fourstix/PicoElfPixieVideoGLCD/docs/PicoElfPixieVideoGLCD.pdf

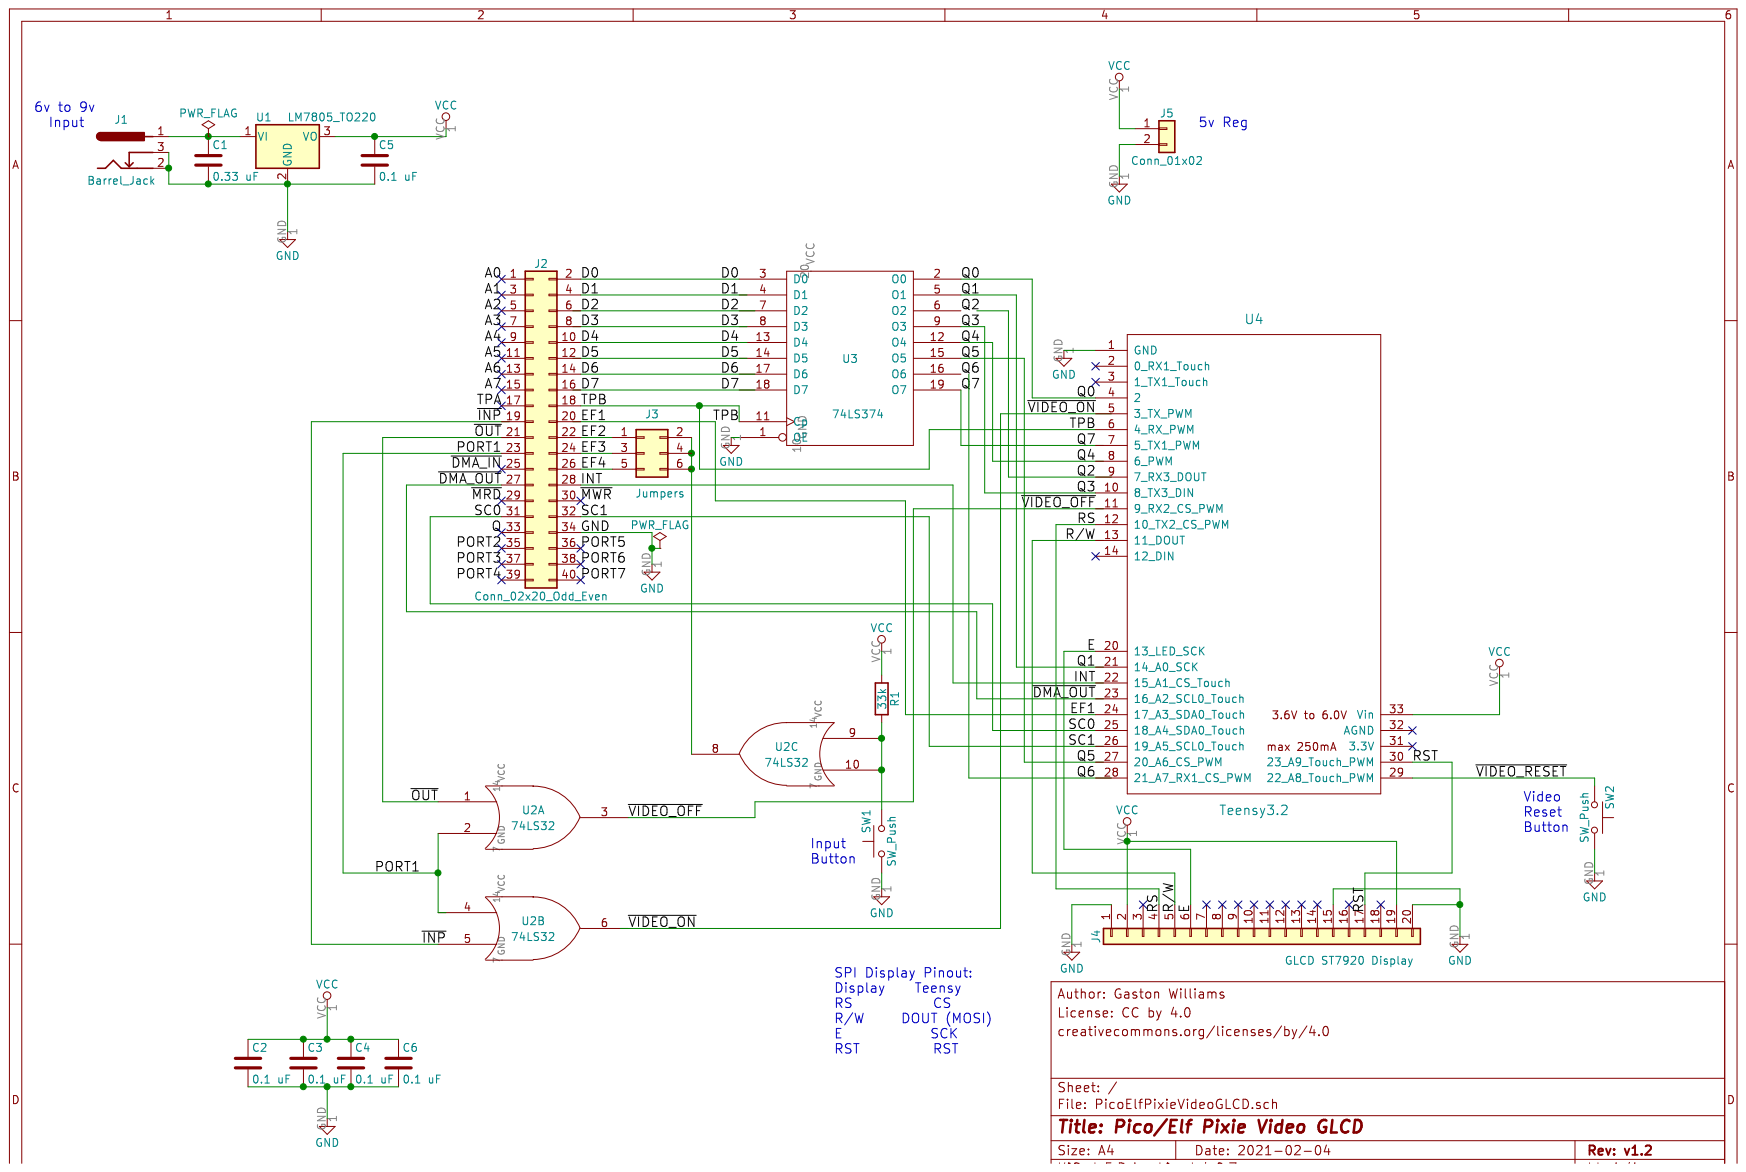
[picture p6: page 1]
