fourstix/PicoElfPixieVideoGLCD/(threads)

Thread 1 (2021-02-03):

Error in Schematic and PCB

fourstix, 2021-02-03:
The connections from the Teensy to the E and R/W display signals are swapped.   E (display pin 6) should go to Teensy pin 13 (SCK) and not to pin 11 (MOSI).  R/W (display pin 5) should go to Teensy pin 11 (MOSI) and not to pin 13 (SCK).

fourstix, 2021-02-04:
Updated schematic with correct connections, regenerated net list and updated PCB layout.  Created Gerber files and KiCad project files.

Closed 2021-02-04.
