fourstix/PicoElfPixieVideoGLCD/(commit log)

2021-01-27 Added Pico/Elf Connector information
2021-02-04 Fixed error in schematic and PCB layout
    [PicoElfPixieVideoGLCD.ino]
